mattbrejza/nixie/sim/high side driver.asc

C1: cap; 100n; ""
C2: cap; 100n; ""
D1: diode; 1N4148
Q1: npn; BC547C
R1: res; 47k; ""
R2: res; 1meg; ""
R3: res; 10meg; ""
R4: res; 40k; ""
V1: voltage; 170; ""
V2: voltage; PULSE(0 3.3 0 1n 1n 90m 100m); ""
V3: voltage; 3.3; ""
V4: voltage; PULSE(3.3 0 300m 1n 1n 1 0 2); ""
Named nets: 0
.tran 0 1 0
