mattbrejza/nixie/pcb/nixie.brd

## EAGLE design pcb/nixie.brd (2013-05-08)

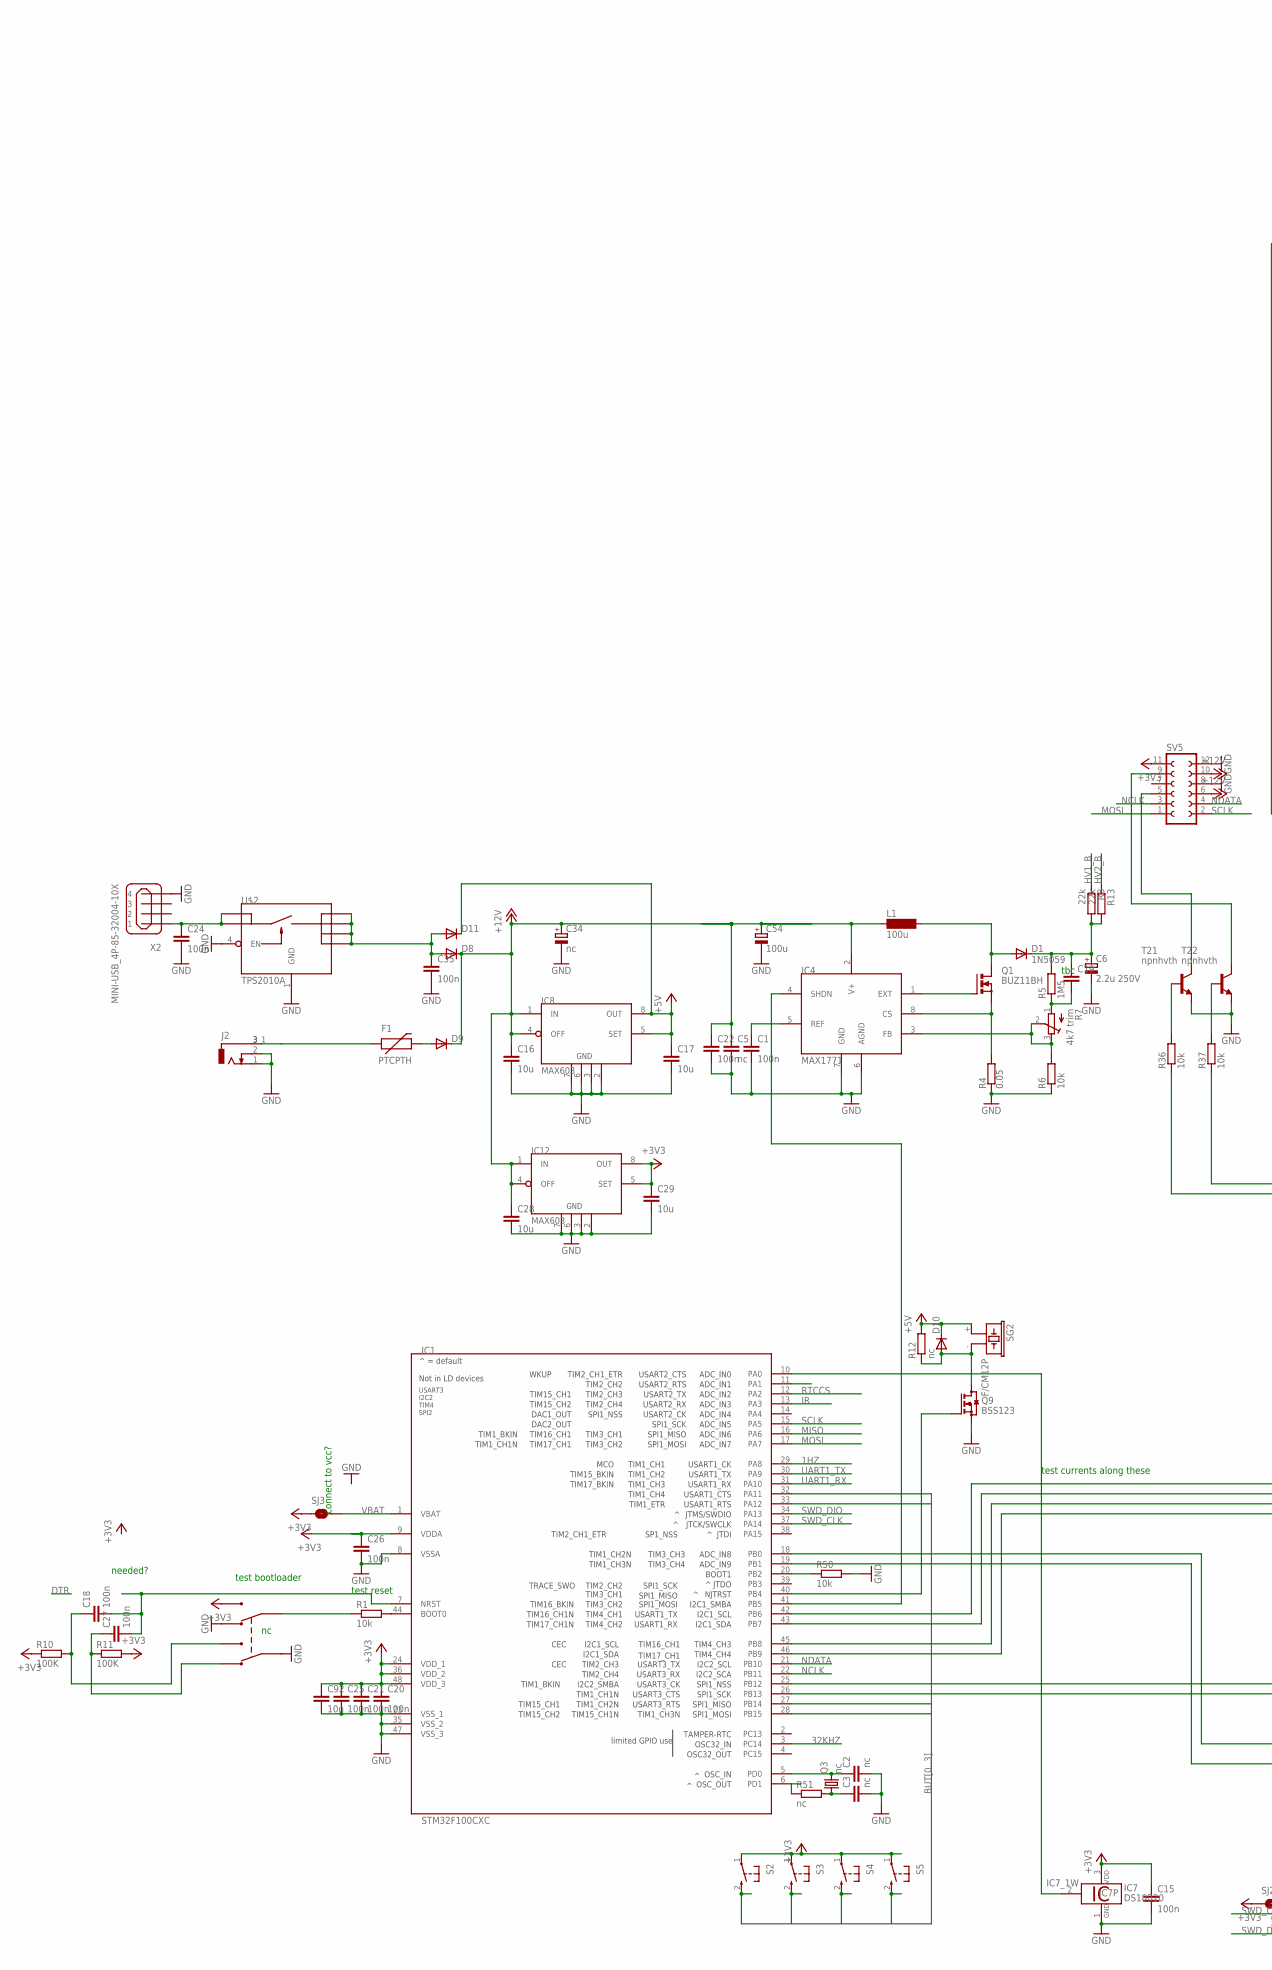
[picture p1: schematic nixie.sch, part in row 1, column 1]

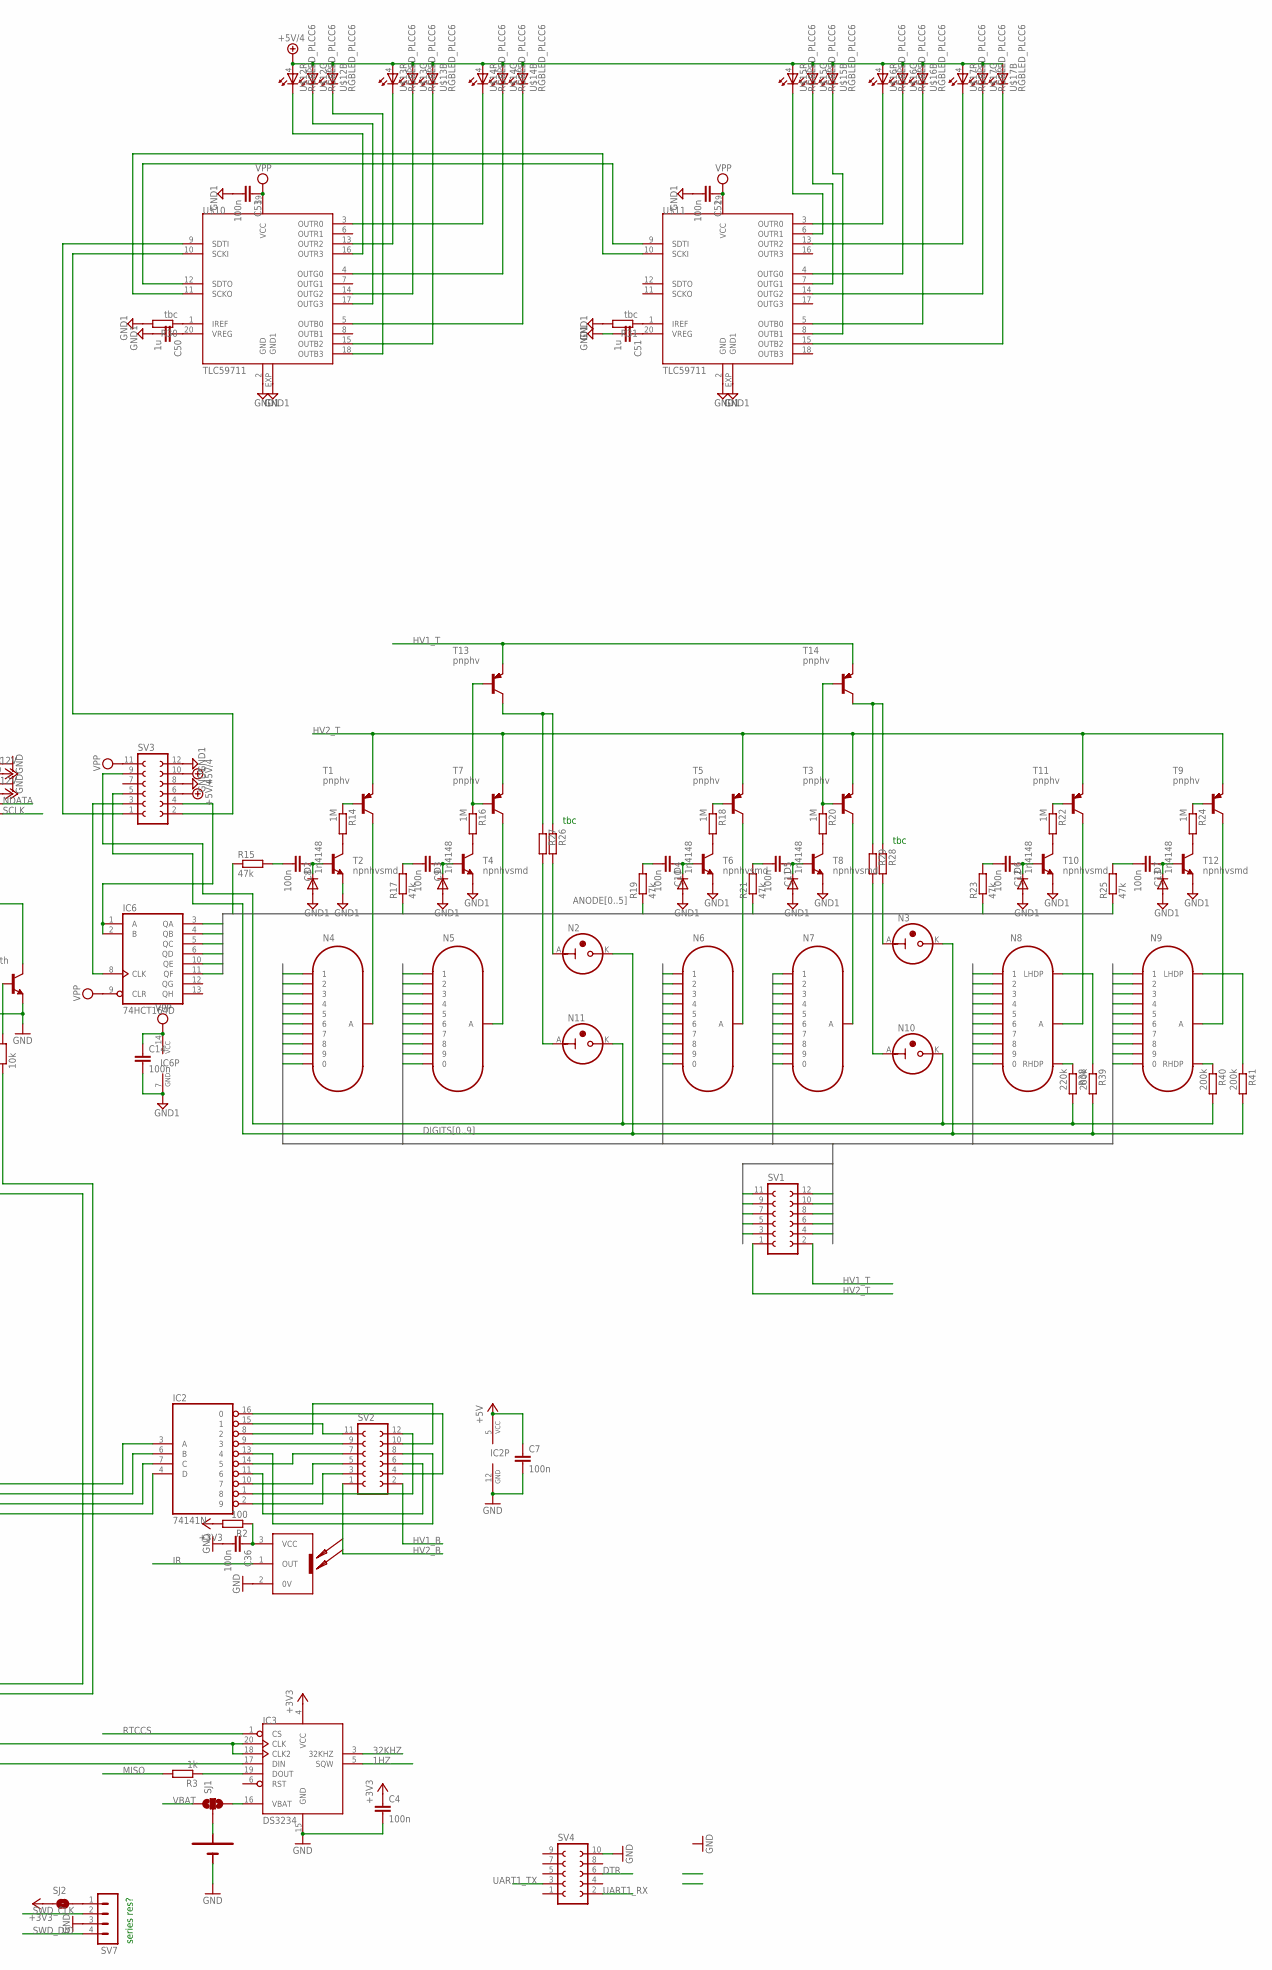
[picture p2: schematic nixie.sch, part in row 1, column 2]

Parts:
BAT1: 2032; COIN
C1, C4, C7, C8, C9, C10, C11, C12, C13, C14, C15, C18, C20, C21, C22, C24, C25, C26, C27, C35, C36, C52, C53: 100n; C0603
C2, C3, C5: nc; C0603
C6: 2.2u 250V; E2,5-6
C16, C17, C28, C29, C92: 10u; C0603
C19: C-EUC0603; C0603
C34: nc; SMC_C
C50, C51: 1u; C0603
C54: 100u; E2,5-6
D1: 1N5059; C1702-05
D2, D3, D4, D5, D6, D7: 1n4148; SOD-323
D8, D9, D10, D11: DIODE-SOD123; SOD123
F1: PTCPTH; PTC
IC1: STM32F100CXC; SQFP-S-7X7-48
IC2: 74141N; DIL16
IC3: DS3234; SO20W
IC4: MAX1771; SO08
IC6: 74HCT164D; SO14
IC7: DS18B20; TO92-
IC8, IC12: MAX603; SO08
J2: DCJ0303SMD; SMD_JACK
L1: 100u; BS11
N2, N3, N10, N11: IN-3
N4, N5, N6, N7: IN-8
N8, N9: IN-16
Q1: BUZ11BH; TO220BH
Q3: nc; CTS406
Q9: BSS123; SOT23
R1, R6, R36, R37, R50: 10k; R0603
R2: 100; R0603
R3: 1k; R0603
R4: 0.05; SMS-WAV
R5: 1M5; R0603
R7: 4k7 trim; RTRIM3314J
R8, R13: 22k; R0805
R10, R11: 100K; R0603
R12, R51: nc; R0603
R14, R16, R18, R20, R22, R24: 1M; R0603
R15, R17, R19, R21, R23, R25: 47k; R0603
R26, R27, R28, R29: R-EU_R0603; R0603
R30, R31: tbc; R0603
R38: 220k; R0603
R39, R40, R41: 200k; R0603
S2, S3, S4, S5: TAC_SWITCH; TACTSIDE
SG2: F/CM12P
SJ1: SOLDERJUMPER_2WAYS; SJ_3
SJ2, SJ3: SOLDERJUMPERNO; SJ_2S-NO
SV1, SV2, SV3, SV5: FE06-2
SV4: FE05-2WED; EDGE_10
SV7: MA04-1E; EDGE_4
T1, T3, T5, T7, T9, T11, T13, T14: pnphv; SOT23-BEC
T2, T4, T6, T8, T10, T12: npnhvsmd; SOT23-3
T21, T22: npnhvth; TO92-EBC
U$1: IRREC
U$2: TPS2010A; SO-08
U$3: DPDTSLIDE
U$10, U$11: TLC59711; HTSSOP20PWP
U$12, U$13, U$14, U$15, U$16, U$17: RGBLED_PLCC6; PLCC6
X2: MINI-USB_4P-85-32004-10X; 85-32004-10X

Connections:
1HZ: IC1.29 (PA8), IC3.5 (SQW)
32KHZ: IC1.3 (PC14), IC3.3 (32KHZ)
+3V3: C4.1, C15.1, C20.1, C21.1, C25.1, C26.1, C29.1, C92.1, IC1.9 (VDDA), IC1.24 (VDD_1), IC1.36 (VDD_2), IC1.48 (VDD_3), IC3.4 (VCC), IC7.3 (VDD), IC12.5 (SET), IC12.8 (OUT), R2.2, R10.1, R11.2, S2.1, S3.1, S4.1, S5.1, SJ2.1, SJ3.1, SV5.11, U$3.2B (NO1)
+5V: C7.1, C17.1, D10.C, D11.C, IC2.5 (VCC), IC8.5 (SET), IC8.8 (OUT), R12.2, SG2.+ (1)
+5V/4: SV3.6, SV3.10, U$12.4 (A), U$12.5 (A), U$12.6 (A), U$13.4 (A), U$13.5 (A), U$13.6 (A), U$14.4 (A), U$14.5 (A), U$14.6 (A), U$15.4 (A), U$15.5 (A), U$15.6 (A), U$16.4 (A), U$16.5 (A), U$16.6 (A), U$17.4 (A), U$17.5 (A), U$17.6 (A)
+12V: C5.1, C16.1, C22.1, C28.1, C34.+, C54.+, D8.C, D9.C, IC4.2 (V+), IC8.1 (IN), IC8.4 (OFF), IC12.1 (IN), IC12.4 (OFF), L1.1, SV5.6, SV5.10
ANODE0: IC6.3 (QA), R15.1
ANODE1: IC6.4 (QB), R17.1
ANODE2: IC6.5 (QC), R19.1
ANODE3: IC6.6 (QD), R21.1
ANODE4: IC6.10 (QE), R23.1
ANODE5: IC6.11 (QF), R25.1
BUT0: IC1.32 (PA11), S5.2
BUT1: IC1.33 (PA12), S2.2
BUT2: IC1.28 (PB15), S4.2
BUT3: IC1.27 (PB14), S3.2
DIGITS0: N4.0, N5.0, N6.0, N7.0, N8.0, N9.0, SV1.3
DIGITS1: N4.1, N5.1, N6.1, N7.1, N8.1, N9.1, SV1.12
DIGITS2: N4.2, N5.2, N6.2, N7.2, N8.2, N9.2, SV1.5
DIGITS3: N4.3, N5.3, N6.3, N7.3, N8.3, N9.3, SV1.6
DIGITS4: N4.4, N5.4, N6.4, N7.4, N8.4, N9.4, SV1.7
DIGITS5: N4.5, N5.5, N6.5, N7.5, N8.5, N9.5, SV1.8
DIGITS6: N4.6, N5.6, N6.6, N7.6, N8.6, N9.6, SV1.9
DIGITS7: N4.7, N5.7, N6.7, N7.7, N8.7, N9.7, SV1.10
DIGITS8: N4.8, N5.8, N6.8, N7.8, N8.8, N9.8, SV1.11
DIGITS9: N4.9, N5.9, N6.9, N7.9, N8.9, N9.9, SV1.4
DTR: SV4.6
GND: BAT1.-, C1.2, C2.2, C3.2, C4.2, C5.2, C6.-, C7.2, C15.2, C16.2, C17.2, C20.2, C21.2, C22.2, C24.2, C25.2, C26.2, C28.2, C29.2, C34.-, C35.2, C36.2, C54.-, C92.2, IC1.8 (VSSA), IC1.23 (VSS_1), IC1.35 (VSS_2), IC1.47 (VSS_3), IC2.12 (GND), IC3.15 (GND), IC4.6 (AGND), IC4.7 (GND), IC7.1 (GND), IC8.2 (GND4), IC8.3 (GND3), IC8.6 (GND2), IC8.7 (GND1), IC12.2 (GND4), IC12.3 (GND3), IC12.7 (GND1), J2.1, J2.2, Q9.2 (S), R4.2, R6.1, R50.2, SV4.10, SV5.8, SV5.12, SV7.3, T21.E, T22.E, U$1.2 (0V), U$2.1 (GND), U$2.4 (EN), U$3.1X (COM0), U$3.2A (NC1), X2.4
GND1: C14.2, C50.2, C51.2, C52.2, C53.2, D2.2 (A), D3.2 (A), D4.2 (A), D5.2 (A), D6.2 (A), D7.2 (A), IC6.7 (GND), R30.2, R31.2, SV3.8, SV3.12, T2.2 (E), T4.2 (E), T6.2 (E), T8.2 (E), T10.2 (E), T12.2 (E), U$10.2 (GND), U$10.EXP (GND1), U$11.2 (GND), U$11.EXP (GND1)
GND2: IC12.6 (GND2)
HV1_B: R8.1, SV2.2
HV1_T: SV1.2, T13.E, T14.E
HV2_B: R13.1, SV2.1
HV2_T: SV1.1, T1.E, T3.E, T5.E, T7.E, T9.E, T11.E
IR: IC1.13 (PA3), U$1.1 (OUT)
LED5: SV3.2, U$10.10 (SCKI)
MISO: IC1.16 (PA6), R3.2
MOSI: IC1.17 (PA7), SV5.1
unnamed: F1.P$1 (1), J2.3, J2.3_1 (4)
unnamed: IC6.1 (A), IC6.2 (B), SV3.4
unnamed: BAT1.+, SJ1.2
unnamed: IC1.25 (PB12), R36.1
unnamed: IC3.19 (DOUT), R3.1
unnamed: IC1.42 (PB6), IC2.3 (A)
unnamed: IC3.16 (VBAT), SJ1.3
unnamed: IC1.19 (PB1), IC3.17 (DIN)
unnamed: IC1.18 (PB0), IC3.18 (CLK2), IC3.20 (CLK)
unnamed: IC1.43 (PB7), IC2.6 (B)
unnamed: IC1.45 (PB8), IC2.7 (C)
unnamed: IC1.46 (PB9), IC2.4 (D)
unnamed: IC4.1 (EXT), Q1.G
unnamed: IC4.8 (CS), Q1.S, R4.1
unnamed: D1.A, L1.2, Q1.D
unnamed: N3.A, R28.2
unnamed: C1.1, IC4.5 (REF)
unnamed: R14.2, T2.3 (C)
unnamed: SV3.1, U$10.9 (SDTI)
unnamed: C19.2, R5.1, R7.1 (E)
unnamed: IC4.3 (FB), R6.2, R7.2 (S), R7.3 (A)
unnamed: R14.1, T1.B
unnamed: C2.1, IC1.5 (PD0), Q3.3 (2)
unnamed: IC1.44 (BOOT0), R1.2
unnamed: N4.A, T1.C
unnamed: C6.+, C19.1, D1.C, R5.2, R8.2, R13.2
unnamed: C13.1, D7.1 (C), T12.1 (B)
unnamed: N5.A, T7.C
unnamed: R16.2, T4.3 (C)
unnamed: R16.1, T7.B, T13.B
unnamed: C13.2, R25.2
unnamed: N6.A, T5.C
unnamed: R18.2, T6.3 (C)
unnamed: R18.1, T5.B
unnamed: C12.1, D6.1 (C), T10.1 (B)
unnamed: R28.1, R29.1, T14.C
unnamed: R20.2, T8.3 (C)
unnamed: R20.1, T3.B, T14.B
unnamed: C12.2, R23.2
unnamed: N8.A, T11.C
unnamed: R22.2, T10.3 (C)
unnamed: R22.1, T11.B
unnamed: C11.1, D5.1 (C), T8.1 (B)
unnamed: N9.A, T9.C
unnamed: R24.2, T12.3 (C)
unnamed: R24.1, T9.B
unnamed: C11.2, R21.2
unnamed: IC1.6 (PD1), R51.1
unnamed: D9.A, F1.P$2 (2)
unnamed: SJ2.2, SV7.1
unnamed: IC1.40 (PB4), Q9.1 (G)
unnamed: N2.A, R26.2
unnamed: N11.A, R27.2
unnamed: D10.A, Q9.3 (D), R12.1, SG2.- (2)
unnamed: N10.A, R29.2
unnamed: N10.K, N11.K, R38.2, R40.2, SV3.9
unnamed: C24.1, U$2.2 (IN1), U$2.3 (IN2), X2.1
unnamed: R37.2, T22.B
unnamed: R36.2, T21.B
unnamed: C18.2, C27.2, IC1.7 (NRST)
unnamed: C35.1, D8.A, D11.A, U$2.5 (OUT1), U$2.6 (OUT2), U$2.7 (OUT3), U$2.8 (OUT4)
unnamed: C27.1, R11.1, U$3.1A (NC0)
unnamed: C18.1, R10.2, U$3.1B (NO0)
unnamed: IC1.26 (PB13), R37.1
unnamed: C10.1, D4.1 (C), T6.1 (B)
unnamed: C10.2, R19.2
unnamed: C9.1, D3.1 (C), T4.1 (B)
unnamed: C9.2, R17.2
unnamed: C8.1, D2.1 (C), T2.1 (B)
unnamed: C8.2, R15.2
unnamed: N8.RHDP, R38.1
unnamed: N8.LHDP, R39.1
unnamed: N9.RHDP, R40.1
unnamed: N9.LHDP, R41.1
unnamed: N2.K, N3.K, R39.2, R41.2, SV3.5
unnamed: IC1.10 (PA0), IC7.2 (1W)
unnamed: R26.1, R27.1, T13.C
unnamed: IC2.16 (0), SV2.4
unnamed: N7.A, T3.C
unnamed: IC2.15 (1), SV2.11
unnamed: IC2.9 (3), SV2.9
unnamed: IC2.14 (5), SV2.7
unnamed: IC2.10 (7), SV2.5
unnamed: IC2.8 (2), SV2.10
unnamed: IC2.2 (9), SV2.3
unnamed: IC2.1 (8), SV2.12
unnamed: IC2.11 (6), SV2.6
unnamed: IC2.13 (4), SV2.8
unnamed: IC6.8 (CLK), SV3.3
unnamed: SV5.5, T21.C
unnamed: SV5.9, T22.C
unnamed: U$10.16 (OUTR3), U$12.3 (B)
unnamed: U$10.13 (OUTR2), U$13.3 (B)
unnamed: U$10.3 (OUTR0), U$14.3 (B)
unnamed: U$10.17 (OUTG3), U$12.2 (B)
unnamed: U$10.14 (OUTG2), U$13.2 (B)
unnamed: IC1.41 (PB5), IC4.4 (SHDN)
unnamed: U$10.4 (OUTG0), U$14.2 (B)
unnamed: C36.1, R2.1, U$1.3 (VCC)
unnamed: U$10.18 (OUTB3), U$12.1 (B)
unnamed: U$10.15 (OUTB2), U$13.1 (B)
unnamed: U$10.5 (OUTB0), U$14.1 (B)
unnamed: U$11.6 (OUTR1), U$15.3 (B)
unnamed: U$11.3 (OUTR0), U$16.3 (B)
unnamed: U$11.13 (OUTR2), U$17.3 (B)
unnamed: U$11.7 (OUTG1), U$15.2 (B)
unnamed: U$11.4 (OUTG0), U$16.2 (B)
unnamed: U$11.14 (OUTG2), U$17.2 (B)
unnamed: U$11.8 (OUTB1), U$15.1 (B)
unnamed: U$11.5 (OUTB0), U$16.1 (B)
unnamed: U$11.15 (OUTB2), U$17.1 (B)
unnamed: C50.1, U$10.20 (VREG)
unnamed: R30.1, U$10.1 (IREF)
unnamed: C51.1, U$11.20 (VREG)
unnamed: R31.1, U$11.1 (IREF)
unnamed: U$10.12 (SDTO), U$11.9 (SDTI)
unnamed: U$10.11 (SCKO), U$11.10 (SCKI)
unnamed: R1.1, U$3.2X (COM1)
unnamed: IC1.20 (PB2), R50.1
unnamed: C3.1, Q3.1, R51.2
NCLK: IC1.22 (PB11), SV5.3
NDATA: IC1.21 (PB10), SV5.4
RTCCS: IC1.12 (PA2), IC3.1 (CS)
SCLK: IC1.15 (PA5), SV5.2
SWD_CLK: IC1.37 (PA14), SV7.2
SWD_DIO: IC1.34 (PA13), SV7.4
UART1_RX: IC1.31 (PA10), SV4.2
UART1_TX: IC1.30 (PA9), SV4.3
VBAT: IC1.1 (VBAT), SJ1.1, SJ3.2
VPP: C14.1, C52.1, C53.1, IC6.9 (CLR), IC6.14 (VCC), SV3.11, U$10.19 (VCC), U$11.19 (VCC)

Notes on the sheet:
test currents along these
series res?
test bootloader
test reset
needed?
connect to vcc?
tbc

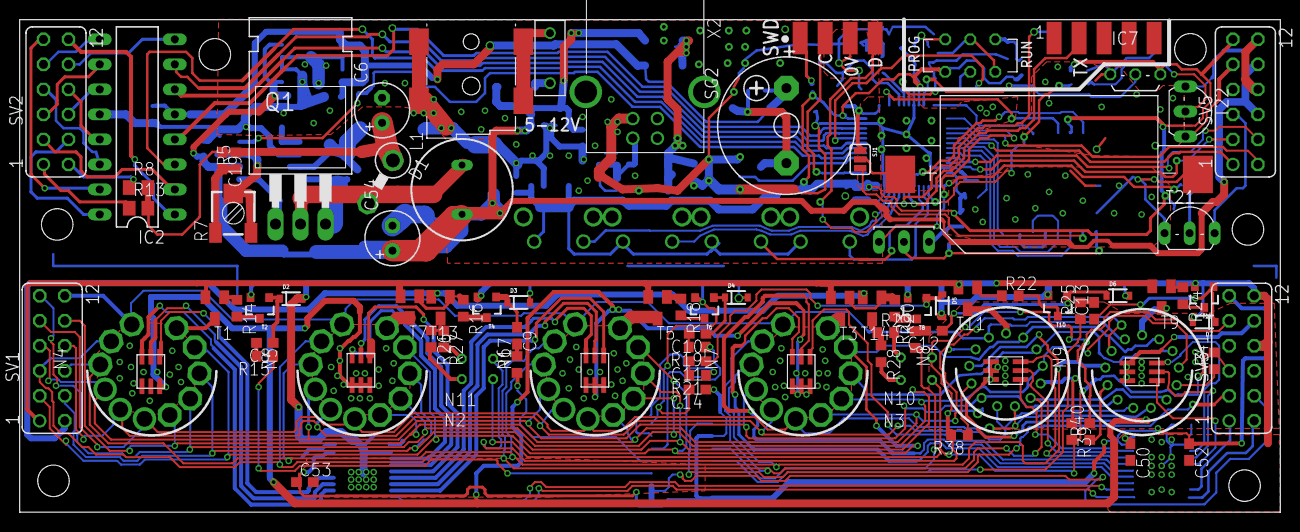
[picture p3: board nixie.brd from above]

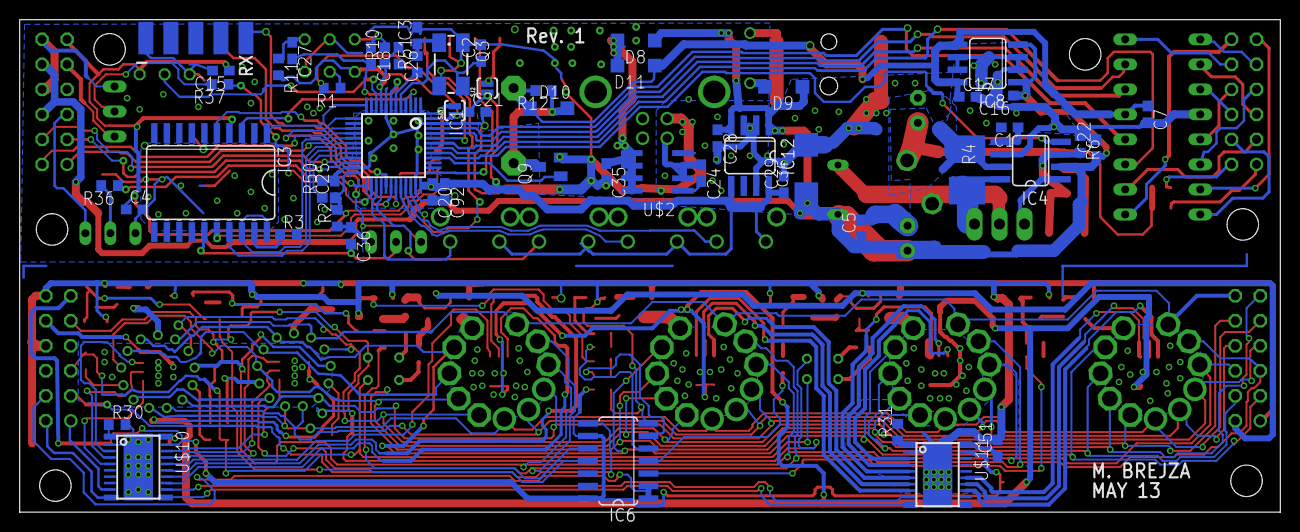
[picture p4: board nixie.brd from below]

Board: 2 copper layers, 128.0 x 50.0 mm, 153 parts (55 on the bottom side), 166 nets.
