mattbrejza/nixie/(commit log)

2013-04-04 moving stuff around
    [nixie.brd, nixie.sch]
2013-04-16 some routing improvements. about to mess about with the inductor area a little
    [nixie.brd, nixie.sch]
2013-04-16 finished moving inductor
    [nixie.brd]
2013-05-02 mostly silk screen stuff
    [nixie.brd, nixie.sch]
2013-05-04 almost done
    [nixie.brd, nixie.sch]
2013-05-07 just before merge
    [nixie.brd, nixie.sch]
2013-05-07 deleted stuff for merging
    [nixie.brd, nixie.sch]
2013-05-07 removing files after being moved somewhere else
    [nixie.brd, nixie.sch]
2013-05-08 off for fab
    [nixie.brd, nixie.sch]
2014-08-23 dma spi and leds working
2015-04-25 fixed flicker due to 1Hz IRQ
    [main.c]
2015-04-27 adding notes to sch
    [nixie.sch]
